adamsls/Analog-to-Digital-Converter/ADC.jpg

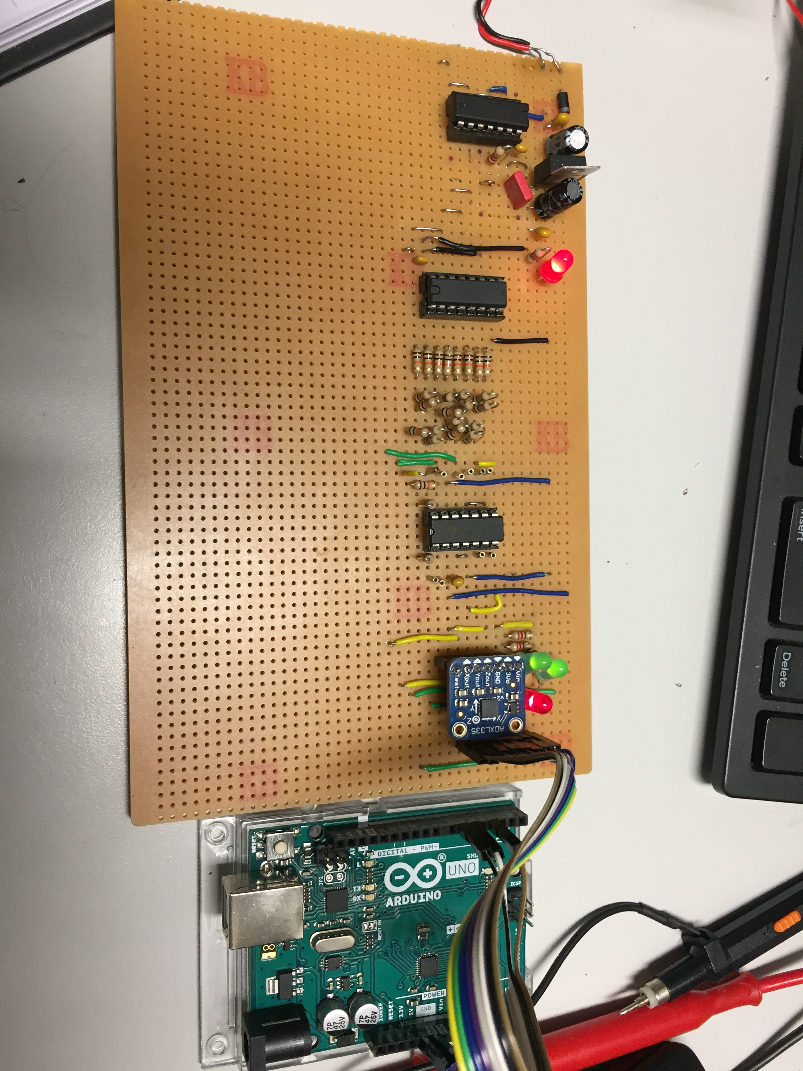
ADC.jpg
