adamsls/Analog-to-Digital-Converter/ADC Project Report.pdf

# FLASHE PROJECT 2019

# Successive Approximation ADC

## LINDA ADAMS

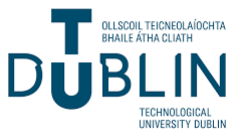
[picture p2: figure]

DEPARTMENT OF ELECTRONIC ENGINEERING TECHNOLOGICAL UNIVERSITY DUBLIN TALLAGHT CAMPUS
JUNE 2019

## Table of Contents

## Introduction

The project outlined in this report involves the construction of a Successive Approximation Analogue to Digital Converter. The circuit takesin an analogue voltage value from an on-board accelerometer and outputs a digital PWM signal, via an embedded Arduino board. Thisreport will describe the functions of the different sections of the converter, the process of building each section and its implementation, and details of how the circuit how tested. Finally, there will be a discussion of the project and what was learned.

## Acknowledgements

With thanks to Fergal Brennan and Martin Fogarty.

## Project planning

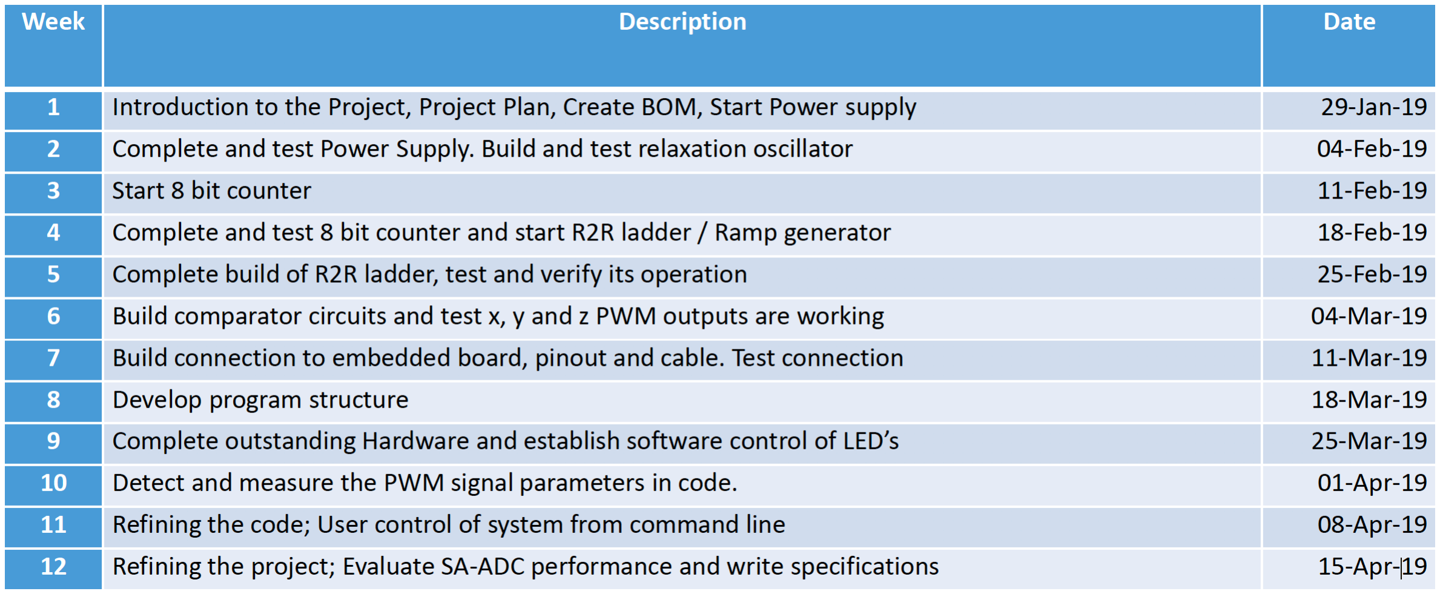
[picture p3: figure]

## Overview of the Circuits

Voltage Regulator

The first section of the ADC consists of a voltage regulator circuit. A voltage regulator is necessary as it important to have a steady, regular power supply to power the rest of the board. This may not be possible from a bench PSU as they may be prone to excessive AC ripple. AC Ripple is the slight variation in a DC signal caused by inadequate conversion of the AC source voltage to DC [1]

The primary component in this section is an LM7805CT, a linear voltage regulator with fixed voltage output of 5V [2]. The LM7805CT is particularly efficient for this purpose as it can dissipate a lot of heat [3]. The regulator functions by essentially comparing the output voltage to a reference voltage and adjusting based on error until the required output voltage is met [4].

Decoupling capacitors are used to filter the input signal from the PSU to the regulator, and are also used on the IC’s output to filter and smooth the output signal. In the context of the full circuit, AC Ripple may potentially become a problem, as it may interfere with the very small reference voltage values output by the ramp generator and the values output by the accelerometer. Therefore it is important to filter the signals in order to reduce AC Ripple as much as possible.

A load resistor is connected to the output of the LM7805CT as is an LED, for testing purposes. A rectifier diode is placed on the IC input, to further reduce AC Ripple.

Relaxation Oscillator

The next section of the ADC consists of a relaxation oscillator. The function of this relaxation oscillator is to act as a clock. The frequency of this clock will determine the eventual Pulse Width Modulation frequency of the output of the comparator..

The primary component at this stage is an LM74AC, a Hex Inverter with Schmitt Trigger Input. The LM74AC chip contains six inverter gates with Schmitt Trigger inputs [5], two of which are used in this circuit.

The first gate functions essentially as a comparator, comparing the input to the gate with negative and positive threshold voltages. According to the datasheet, the negative threshold for a 5V input is 1V, and the positive 3.55V. A capacitor is placed on the inverting input of the gate, and it is the rate of discharge/discharge of this oscillator that determines the frequency of the output of the oscillator. When the gate is powered, there will be 5V on its output which will then be fed back to the inverting input, causing the capacitor to begin charging. When the capacitor reaches 3.55V, it will then be greater than the positive threshold voltage, and so the output will switch to 0V. At that point the capacitor will begin discharging. When it discharges to the point where it is less than the negative threshold voltage, then the output will switch to 5V. In this way, a 5V square wave is generated. Schmitt Trigger inputs implement hysteresis in the form of the thresholded range of voltages described above (1V – 3.55V). This is used in order to avoid rapid fluctuations between 0V and 5V.

Counter

In this stage of the ADC, a counter is used to create an 8-bit count from 0 to 255, which will be used to generate a ramp output from the next stage of the circuit. The main component in this section is an SN74HC590, an 8-bit digital counter. The clock input to this binary counter comes from the relaxation oscillator built in the previous section. The output of the oscillator was found to be 188.7kHZ, and so this will be twice the frequency of the Least Significant Bit (LSB) of the counter output. If we count the LSB as the “1st” bit and the MSB as the “8th”, then the nth bit will be have a frequency that is 2" divisions of the LSB frequency, i.e.:

ntℎ bit frequency = 188,700 2"
According to the SN74HC590 datasheet [6], the IC contains both a counter and a storage register, with a separate clock input for each of these. The counter clock is positive-edge triggered, meaning that when the oscillator transitions from low to high, the counter will increment. The clock may be reset through the !CCLR clock clear pin, or enabled through the !CCKEN clock enable pin. An RCO (Ripple Carry Output) pin may be used if multiple counters were to be chained together.

Ramp Generator

The next section of the circuit consisted of an R2R Resistor Ladder. An R2R Ladder is essentially a series of voltage dividers that output a ramp voltage. This ramp voltage will function as a reference voltage to which the eventual output of the accelerometer will be compared.

The input to the R2R ladder is the 8-bit output of the counter. This consists of 8 separate square wave signals, each half the frequency of the next. Given that these are binary signals, the R2R ladder can be thought of as functioning as a local digital-to-analogue converter [7], within the global analogue-to-digital circuit.

Each bit contributes a proportional amount of voltage to the total summed voltage at the output of the R2R ladder, resulting in a 5V sawtooth wave.

Comparator

At the nextstage of the circuit, an ADXL335 3-axis accelerometer will be added to the board. The accelerometer will output voltage values relative to its rate of acceleration in the x-, y-, and z-axes. These voltage values will be compared to the ramp output of the R2R ladder, using an LM339 chip, which contains four comparators [8]. For each axis signal comparison, a Pulse Width Modulated square wave will be output, whose duty cycle ratio corresponds to the acceleration in that axis.

In this way, the analogue voltage output of the accelerometer is converted to digital values that may be interpreted by an Embedded System.

Embedded Interface

At this stage of the circuit, pin headers are soldered to the board so that an ADXL335 3-axis accelerometer and an Arduino Uno SMD may be added. The accelerometer outputs analogue voltage values relative to its rate of acceleration in the x-, y-, and z-axes. The values are then routed to the comparator, which compares them to the analogue reference ramp voltage and outputs three digital Pulse-Width Modulated signals. The PWM signals can be interpreted as the positions of the accelerometer in the X, Y, and Z planes, or as g-force values between -3g and 3g. The values are routed to the Arduino. A programme is embedded onto the Arduino which can interpret the incoming PWM signals and display these in the serial monitor.

Coding

There are three values from the accelerometer that will need to be read and interpreted by the embedded Arduino programme. Therefore, there are three main functions within the code, each containing a switch statement for the individual axis readings. For example, when the ‘x’ key is pressed by the user, the variable pwm_x_measurement is set to ‘THI’, and a boolean flag named ok_to_measure_pwmx is asserted. This allows the function to measure the x-axis value from the accelerometer, MeasurePWMX, to be called, with pwm_x_measurement, set to ‘THI’, as an initial argument. The first case of the switch statement is implemented, which contains a call to the inbuilt Arduino function pulseIn() [9]. PulseIn() reads the PWM input from the given pin and returns its HIGH duration in microseconds, which is assigned to pwm_x_thi. The switch breaks and the flag, still asserted, is rechecked. MeasurePWMX is again called, and the next case of the switch statement implemented, with pwm_x_measurement set to ‘TLO’, and the LOW duration of the PWM signal is returned. In the next case, the low and high values are summed to give the period of the PWM signal. In the next case, the function CalculateVin is called, which divides the HIGH duration by the clock period. This gives the number of steps that the ramp has incremented while the comparator output is high. Multiplying this value by resolution of the ramp 6

788
9: ;, gives the voltage value coming from the accelerometer. This value is them

displayed on the serial monitor, as is the HIGH duration, LOW duration and the total PWM period.

Functions to calibrate the board and to convert voltage values to G forces, using points taken during calibration and determining the line equation for each axis, are added.

## Implementation of the Circuits

Voltage Regulator

In this section of the circuit, a DC voltage is taken from a bench PSU (or battery). A ground rail is also established at this point. The input voltage is sent through first through a rectification diode, in order to alleviate AC Ripple. It is further smoothed using an input filter consisting of decoupling capacitors and finally routed through the input pin of the LM7805CT voltage regulator. According to the datasheet for the LM7805CT, the dropout voltage is 2.0V. This means that for an output of 5V, we can calculate the expected minimum required voltage from the PSU as:

V=>? + VAB=C=>? = VDE(GDE)

∴ 5V + 2V = 7V

According to the datasheet, the maximum input voltage should be 35V. A voltage of 12V is used, giving ample headroom on either side. The datasheet states that the output voltage tolerance is +/- 4%, and therefore we can calculate the expected output voltage range as:

V=>?(BKELM) = 5V ± 4%

∴ V=>?(BKELM) = 5V ± 0.2V

∴ 4.8V ≤ V=>? ≥ 5.2V

The resulting 5V (+/- 4%) is routed through an output filter for smoothing and then sent through a diode and load resistor.

It is important to ensure that there are no short circuits in this section, as this may cause the LM7805CT to overheat due to too much current flowing through it. If the regulator overheats and enters thermal shutdown, its output voltage may drop below the required value [3].

Relaxation Oscillator

In this second stage of the circuit, the voltage regulator output is routed to the input of a relaxation oscillator, built from an LM74AC IC described above. The output of this oscillator is a square wave, which has been generated via one of the inverter gates of the IC. A second inverter gate functions as a clock buffer to smooth the square wave and reduce noise.

The expected frequency output of the oscillator is a function of the time constant of the circuit and the various input and threshold voltage values [10]. Therefore, when calculating this value, the RC constant must first be determined. The resistance and capacitance of R and C were measured:

RUVWXYZV[ = 214.8Ω

CUVWXYZV[ = 21.218nF

∴ RCUVWXYZV[ = 214.8 × (21.819 × 10ab)

∴ RCUVWXYZV[ = 4.6867 × 10ad

This may be compared to the labelled values of the components in order to illustrate the range of tolerance in component labelling:

ReWfVeeV[ = 220Ω

CeWfVeeV[ = 22nF

∴ RCVghVijV[ = 220 × (22 × 10ab)

∴ RCVghVijV[ = 4.84 × 10ad

The deviation between the expected and the measured may then be calculated as a percentage:

Percentage error = |RCUVWXYZV[ − RCVghVijV[|
RCVghVijV[

×

100
1

= 1.522 × 10aq
4.84 × 10aq ×

100
1

= 3.17%

The overall output square wave frequency is determined by the following calculation:

f = | 1
RC ln 6
| Vuu − V?a Vuu − V?v
×

V?v
V?a

;

RC was determined above to be 4.84 × 10ad and VCC determined to be 5.06V (see Testing and Results – Voltage Regulator). However, the VT- and VT+ values were not so easily determined as they were found to be values within a given tolerance range, according to the datasheet. Therefore, the potential output frequency had to be calculated within that range, with RC and Vcc as constants, and VT- and VT+ as variables. The calculated values are listed below (the excel table for these values may be found in the appendix):

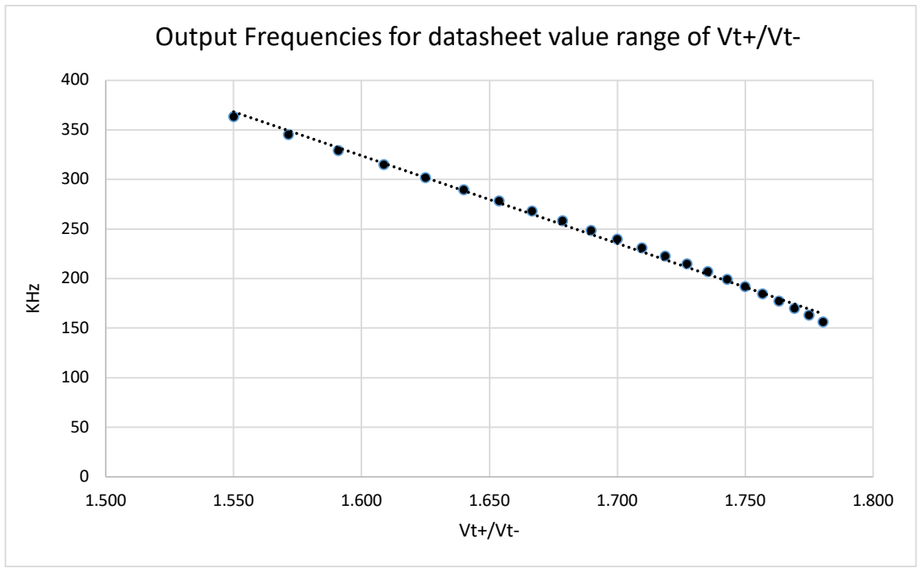
[picture p4: figure]
KHz

Counter

At this stage of the circuit, the output of the relaxation oscillator is routed to the clock input pins (CCLK/Counter and RCLK/Registry) of the SN74HC590. The active low CCLR/Counter Clear pin is routed to the 5V line in order to prevent the counter being cleared to 0, and the

Output Frequencies for datasheet value range of Vt+/Vt-active low OE/Output Enable and CCKEN/Count Enable pins are routed to ground to ensure that the count will continue.

The SN74HC590 will output, from 8 separate pins, parallel binary values that will constitute an 8-bit count from 0 to 255:

Decimal | Bit 7 (MSB) | Bit 6 | Bit 5 | Bit 4 | Bit 3 | Bit 2 | Bit 1 | Bit 0 (LSB)
0 | 0 | 0 | 0 | 0 | 0 | 0 | 0 | 0
1 | 0 | 0 | 0 | 0 | 0 | 0 | 0 | 1

254 | 1 | 1 | 1 | 1 | 1 | 1 | 1 | 0
255 | 1 | 1 | 1 | 1 | 1 | 1 | 1 | 1

Table 1: 2^8 binary output values

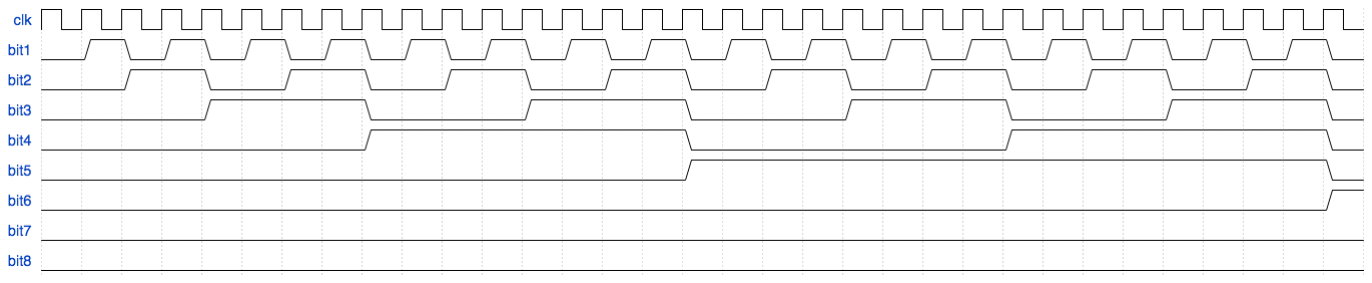
[picture p5: figure]

Figure 1: Section of 8-bit counter timing diagram
Each of these binary outputs will constitute an on/off voltage of 0V and 5V which will be fed into an R2R resistor ladder in the next stage of the circuit. The resistor ladder will take this square wave input and convert it into a ramp voltage.

Ramp Generator

Each square wave signal from the counter, detailed in the previous section, is routed separately to the R2R ladder. The ladder is set up in such a way that each individual square wave meets a different level of impedance, which is inversely proportional to the associated bit’s significance in the overall 8-bit byte [11]. For example, the Most Significant Bit meets the minimum level of resistance and the Least Significant Bit meets the maximum level. This means that each bit allows for a voltage output proportional to its significance, i.e. MSB allows for the maximum voltage, LSB allows for the minimum.

This proportional voltage output is achieved through the ladder sequence of voltage dividers, with values of 2R for R1 and 2R (through Thevenin equivalence [12]) for R2. Each bit is connected to a voltage divider and must travel through its connected voltage divider, plus all subsequent voltage dividers. Hence, each bit voltage is successively divided, relative to its significance. For example, the LSB must travel through eight voltage dividers, which reduces its voltage by 2w. The MSB must only travel through one voltage divider, reducing its voltage by 2x. If we count the LSB as the “8th” bit and the MSB as the “1st”, then the nth bit will contribute voltage according to the following equation:

ntℎ bit voltage output = V|" 2"

Bit number | Expected voltage output (when high)
1 (MSB) | }.~d7 9 = 2.53V
2 | }.~d7 9Ä = 1.265V
3 | }.~d7 9Å = 0.633V
4 | }.~d7 9Ç = 0.316V
5 | }.~d7 9É = 0.158V
6 | }.~d7 9Ñ = 0.079V
7 | }.~d7 9Ö = 0.040V
8 (LSB) | }.~d7 9: = 0.020V
Total (max - 255) | 5.04V

Table 2: Calculated voltage output values for individual bits

The resulting voltages are summed, with the maximum value of the sum being the initial square wave peak voltage of 5V. As the binary counter increments, the summing voltages increase proportionally to the bits, resulting in a ramp voltage. Given that the minimum contribution to the ramp is the input voltage having travelled through eight successive voltage dividers, the resolution of the ramp is:

Resolution = V|"
2w
Resolution = 5.06V
256

Resolution = 19.77mV

The resolution of the ramp is extremely important, as this will be the minimum voltage that can be compared with the output of the accelerometer.

The construction of the circuit involved placing the resistors according to the network structure. The R resistor value in this case was 5kW. Two 10kW resistors were used for the R value instead of a single 5kW resistor, as this increases tolerance from ± 5% for a single resistor to ± 2.5%.

Comparator

At this point, the ramp voltage is routed to three inverting inputs of the inverting LM339 comparator. When the ADXL335 3-axis accelerometer is added to the board, then its 3-axis outputs will be routed to the non-inverting inputs of the LM339. However, during the implementation phase of this circuit, test voltages are taken from the bench PSU, in order that the functioning of the comparator may be easily tested using known values.

The comparator functions by comparing two input signals and outputting a binary “high” signal when the non-inverting input is greater than the inverting input. When the reverse is true, a binary “low” value is output. As the accelerometer voltage will be compared to a sawtooth wave, the output will be constantly low if the accelerometer output is low, constantly high if the accelerometer output is high, and a 50% duty cycle square wave if the accelerometer output is at its mid-point. Given a constant DC test voltage input from the PSU during testing, the output will be high for all points where the test voltage is higher than the ramp voltage, as seen below (adapted from [13]):

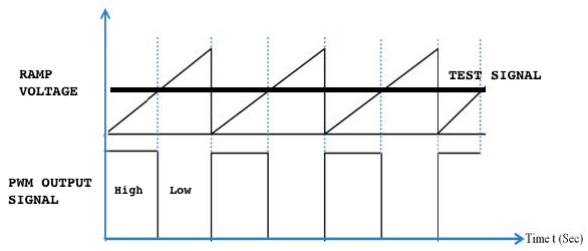
[picture p6: figure]

Figure 2: PWM Output from Comparator

One of the issues involved with Pulse Width Modulated signals is that of “cross-over”. This refers to the problem of measuring the maximum and minimum values of a PWM signal. If the test signal is at a maximum or minimum, then it will be fully higher or fully lower than the reference signal. If this occurs then there will be no differentiation between high and low in the output, and the output will cease to have a frequency component. This means that it will become a DC signal with a constant voltage of max or 0. Therefore it is important to find the minimum and maximum voltages at which a frequency exists. These will determine the specifications within which the device may operate.

The system transfer function must be determined at this point, in order to be able to understand exactly how the PWM output of the comparator relates to the actual voltages produced by the accelerometer. The values that will determine this transfer function are the ramp voltage (F_RAMP), frequency of the oscillator (F_CLK) and the supply voltage (VCC). Some of these values were measured/calculated at various other points:

Fuàâ = 188.7kHz

VCC = 5.06V

The frequency of the square wave ramp may be calculated by dividing the clock frequency by the number of steps in the ramp, as each step in the square wave occurs at the pulsing of the clock:

FBKGC = 188.7kHz
2w
FBKGC = 737.1Hz

The period of the ramp (and thus the period of the PWM output) is the reciprocal of the frequency:

TBKGC = 1 737.1Hz

TBKGC = 1.36ms

The resolution of the ramp has previously been calculated as 19.77mV. In order to calculate the duration that the PWM will be high or low given a test input signal, the number of steps required by the ramp to reach that test value must be calculate:

NUM_STEPS = V?Mî? Resolution

As we cannot have a non-integer amount of steps, this number must be rounded, which introduces a rounding error. The rounding error may be found by subtracting the calculated value (step voltage * step number) from the actual test value.

The time taken for the ramp to reach the test voltage is equal to the ramp step time (clock period) multiplied by the amount of steps required. This time value represents the duration that the output PWM signal will be high:

TïDLï = Tuàâ × NUM_STEPS

The duration that the PWM signal will be low may be found by subtracting T_HIGH from the overall period of the ramp, T_RAMP:

Tà=ñ = TBKGC − TïDLï

Therefore, if T_CLK for this circuit is 5.3µs, and the resolution is 19.77mV, then the high PWM value for any test input may be found using:

TïDLï = V?Mî? ×

Tuàâ
Resolution
TïDLï = V?Mî? × (2.68 × 10aó)

Embedded Interface

During the implementation of the embedded interface stage, some rerouting was required. At this point, the 5V signal from the voltage regulator was no longer required to pull up the outputs of the comparator, as 5V would now be taken from the Arduino. This required the removal of the link between the comparator output signals and the voltage regulator 5V line, since there would be no common reference if two different 5V supplies were used. Additionally, a link needed to be made to the 5V Vcc input from the Arduino.

Two pin headers were required in order to allow for both a 3-axis accelerometer, the ADXL335, and an Arduino Uno SMD to be connected.

According to the datasheet for the ADXL335 [14], the device operates by measuring the differential capacitance between a fixed plate and a plate attached to a mass, which moves when the device is moved. This differential represents the acceleration within a given axis, which may also be converted to a g-force value. The ADXL335 contains an on-board regulator, which allows it to operate within a 3.3V range while taking in a 5V input [15]. It outputs ratiometric/proportional values, meaning that the range of output voltages is scaled along with the possible range of g-force values available.

On the circuit, the X, Y and Z acceleration outputs were routed from the pin header to which the ADXL335 will be connected to the test voltage inputs of the comparator.

## Bill of Materials

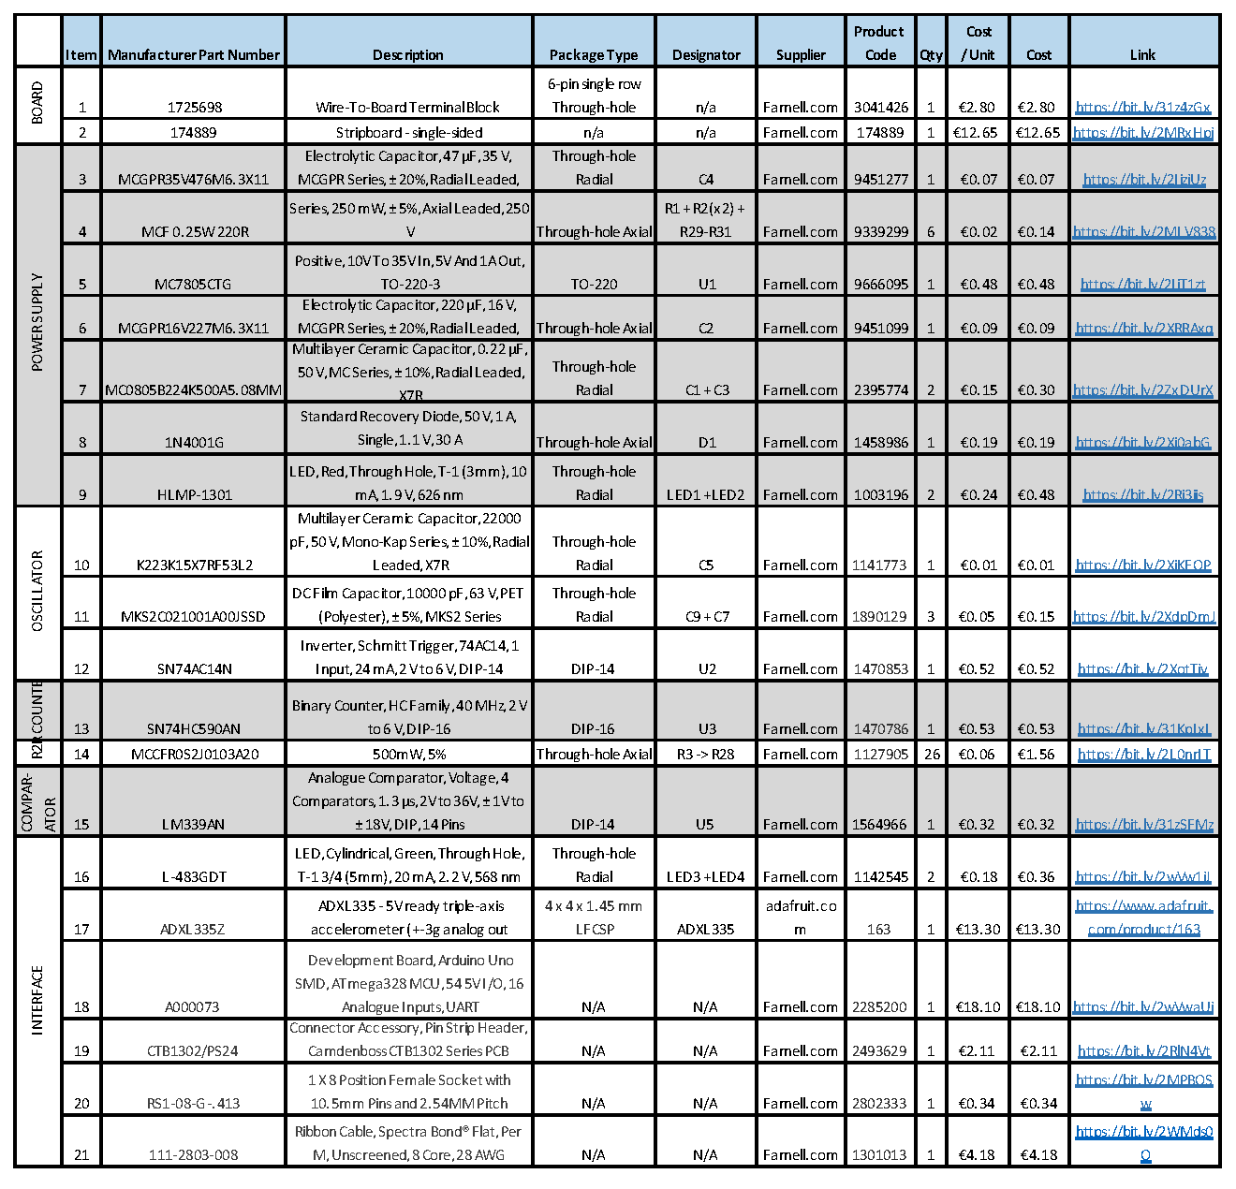
[picture p7: figure]

## Errors

Some errors occurred at various stages during the implementation of the circuit. These were dealt with as follows:

Voltage Regulator

During the voltage regulator stage, the terminal block component was found to have been soldered incorrectly to the board, as it had been positioned backwards. The component was removed using solder removal braid and a new component sourced and resoldered.

Relaxation Oscillator

Initial tests of the relaxation oscillator showed that it was not outputting at the expected frequency. After inspection of the board, it was found that some cuts in the board had not been made properly, and some unintentional connections in the tracks remained. After recutting the appropriate sections, the oscillator began clocking at the expected frequency.

R2R Ladder

It was initially found that the ramp voltage from the R2R was not incrementing smoothly, but rather was jagged and uneven. On inspection of the board, it was found that a track cut had not been made. The appearance of the ramp improved significantly one the cut was made.

Embedded Interface

On testing the PWM output of the comparator, it was found that a signal was not being obtained for the Z-axis of the accelerometer. After inspecting the circuit visually, a burned section of the board was found between the PWM_Y output of the 5V line, through the pull-up resistor. This was subsequently rerouted, but the problem persisted. Continuity measurements were then taken, and it was found that the connection between the Y-axis output of the accelerometer header and the comparator input was broken. This also was then rerouted, but again the problem persisted. Resistance values were then taken using the multimeter, and a short to ground at the U-output of the comparator was discovered. A visual inspection of the board revealed an accidental connection to the ground line through excess solder on a joint. The joint was de-soldered and cleaned up, and this appeared to solve the problem.

Coding

An issue was found with the PulseIn() function of the embedded code. On occasion, the function returned erroneously low values for the HIGH PWM duration, in the area of 10 – 20 µs. On inspection of the PWM signal using the oscilloscope, it was discovered that there were slight glitches in the X and Z signals, where the value went from HIGH to LOW to HIGH again, or vice versa, over the course of approximately 20µs. According to the Arduino documentation for PulseIn(), the function waits for the pin value to change and then begins timing. It then waits for the value to change again and stops timing [9]. Therefore it is likely that the function was reading the PWM glitches as valid signals. Since the function waits for the value to change, it was decided that a debounce-type solution may be effective, and an if-statement included in the ReadPulse() function that implemented a new call to PulseIn() if the initial value was less than 20µs. This appeared to solve the problem.

## Testing and Results

Voltage Regulator

Given that the main function of the voltage regulator is to output a specified voltage, the first test performed was on the output voltage of this section of the circuit. As calculated above (see Implementation – Voltage Regulator), the expected output was between 4.8V and 5.2V. The output voltage, when tested, was found to be 5.06V, within the expected margin of error. AC Ripple was also measured at this stage and found to be approx. 50mV. The minimum input voltage was calculated above to be approx. 7V. When measured, this value was found to be 7.23V, which was reasonably close to the expected value. The current from the bench PSU was also measured, and found to be 17.9mA

Minimum | Typical | Maximum
7V | 12V | 35V

Table 3: Input Voltage Values

Value | Description | Expected | Measured
Vin Min | Minimum input voltage | 7V | 7.23V
VDD | Output voltage | 4.8V -> 5.2V | 5.06V
PIN | Input current | ---------- | 17.9mA
VAC RIPPLE | AC Ripple on input voltage | ---------- | 50mV

Table 4: Test Results for Voltage Regulator

Relaxation Oscillator

Values related to the input and output of the oscillator were tested at this stage, in order to ensure that this section of the circuit was functioning correctly. The estimated value for the output frequency was 159.35kHZ ≤ f ≥ 365.23kHz (see Implementation – Relaxation Oscillator). When measured on the oscilloscope, the output period was found to be 5.3 μs, which meant that the frequency was 188.7kHz, which is within the expected range. The ratio of positive to negative pulse width was measured, with the positive width found to be 2.9 μs and the negative 2.4 μs. Ideally, these would have the same value, but the unequal ratio was not found to be overly problematic. The rise time and fall time were also measured, and found to be 30ns and 20ns, respectively.

As before, the voltage and current into the circuit and the AC ripple were measured to see if they had changed given the expansion of the circuit. They were found not to have deviated significantly.

Value | Expected | Measured
Circuit voltage | 12V | 12.8V
Circuit current | ----- | 29mA
Positive pulse width | ----- | 2.9µs
Negative pulse width | ----- | 2.4µs
Output frequency | 159 -> 365 kHz | 188.7kHz
Output Period | 1/159k -> 1/365k seconds | 5.3µs
Rise time | ---- | 30ns
Fall time | ---- | 20ns

Table 5: Test Results for relaxation oscillator

Counter

Testing at this stage of the circuit involved determining the output frequencies of each of the 8 output pins of the counter and comparing these frequencies to expected values.

Frequencies were calculated using the equation:

ntℎ bit frequency = 188,700 2"

Output | Calculated Frequency (Hz) | Measured Frequency (Hz) | Difference (Hz) | Difference (%)
Bit 1 (O/p A0) | 188,700 / 2 = 94,350 | 95,700 | + 1350 | 1.4
Bit 2 (O/p A1) | 188,700 / 4 = 47,175 | 47,000 | -175 | 0.3
Bit 3 (O/p A2) | 188,700 / 8 = 23,587 | 23,900 | +313 | 1.3
Bit 4 (O/p A3) | 188,700 / 16 = 11,794 | 11,900 | +196 | 0.9
Bit 5 (O/p A4) | 188,700 / 32 = 5,897 | 5,980 | +83 | 1.4
Bit 6 (O/p A5) | 188,700 / 64 = 2,984 | 3,000 | +16 | 0.5
Bit 7 (O/p A6) | 188,700 / 128 = 1,474 | 1,490 | +16 | 1.1
Bit 8 (O/p A7) | 188,700 / 256 = 737 | 747 | +10 | 1.3

Table 6: Test Results for 8-bit Counter

AC Noise was again measured at this point and found to be approx. 25mV, and power consumption was calculated from the input voltage and current and found to be 0.36 Watts.

Ramp Generator

The ramp generator was tested by measuring the resistance values throughout and across the circuit and comparing them to expected calculated values. If the resistance values were found to be correct, then it is assumed that the voltage values contributing to the ramp will be correct.

Test Point 1 | Calculated Value | Measured Value | Difference (%)
GND to A0 | 20kW | 19.68kW | 1.61
GND to A1 | 25kW | 24.50kW | 2.02
GND to A2 | 30kW | 29.42kW | 1.95
GND to A3 | 35kW | 34.28kW | 2.08
GND to A4 | 40kW | 39.20kW | 2.02
GND to A5 | 45kW | 44.10kW | 2.02
GND to A6 | 50kW | 49.01kW | 1.99
GND to A7 | 55kW | 53.98kW | 1.87

Table 7: Measured and calculated resistances across R2R ladder

Test Point 2 | Calculated Value | Measured Value | Difference (%)
A0 to A1 | 25kW | 24.49kW | 2.06
A1 to A2 | 25kW | 24.42kW | 2.34
A2 to A3 | 25kW | 24.41kW | 2.38

A3 to A4 | 25kW | 24.41kW | 2.38
A4 to A5 | 25kW | 24.43kW | 2.31
A5 to A6 | 25kW | 24.42kW | 2.23
A6 to A7 | 25kW | 24.50kW | 2.02
A7 to A0 | 55kW | 53.80kW | 2.21

Table 8: Measured and calculated resistances within R2R ladder

In addition, the output ramp voltage was checked on the oscilloscope to ensure that it was outputting the correct shape and magnitude sawtooth wave. As seen below, the output voltage was found to be a 5V sawtooth wave as expected, and the step size was found to be approximately 20mV:

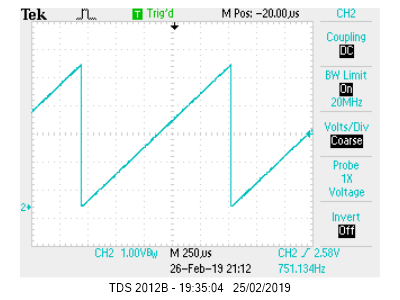
[picture p8: figure]

Figure 3: Ramp output of R2R ladder

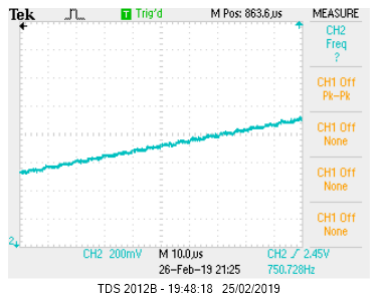
[picture p9: figure]

Figure 4: Individual step size in ramp output

AC Noise was again measured at this point and found to have increased significantly from 25mV to approx. 60mV with the addition of the R2R ladder to the circuit.

Comparator

Testing for the comparator involved using the oscilloscope to find the minimum test input voltage value for which the output PWM signal had both a high and low portion. Beyond this point, the PWM will be a DC signal with only a continuous low value, which is of no use. The maximum voltage value was also measured. The useful range of voltages was thus calculated.

In addition, the frequency, period, and voltage of the PWM signal was measured and compared to calculated values, and a range of high/low PWM durations were measured for the test input.

Finally, the power consumption of the circuit at this point was found to be 0.41W, an increase on the previous value of 0.36W

Value | Expected | Measured
| | X | Y | Z
Vsig_min | ------- | 9mV | 9mV | 8mV
Vsig_max | ------- | 5.062V | 5.06V | 5.1V
Vsig_range | ------- | 5.053V | 5.051V | 5.092V
VPWM | 5.06V | 5.12V | 5.12V | 5.12V
F_PWM | 737.1Hz | 752.7Hz | 751.8Hz | 746Hz
T_PWM | 1.36ms | 1.33ms | 1.33ms | 1.34ms

Table 9: Measured and calculated values for comparator

Vsig | X | Y | Z
| Pos PWM | Neg PWM | Period | Pos PWM | Neg PWM | Period | Pos PWM | Neg PWM | Period
1V | 263.9µs | 1.065ms | 1.33ms | 270µs | 1.06ms | 1.33ms | 269.1µs | 1.071ms | 1.34ms
2V | 523.2µs | 806.1µs | 1.33ms | 521.9µs | 808.1µs | 1.33ms | 527.8µs | 812.2µs | 1.34ms
3V | 807.9µs | 520.8µs | 1.33ms | 810µs | 520µs | 1.33ms | 814.6µs | 525.4µs | 1.34ms
4V | 1.053ms | 276µs | 1.33ms | 1.072ms | 258µs | 1.33ms | 1.063ms | 276µs | 1.34ms

Table 10: Measured PWM values

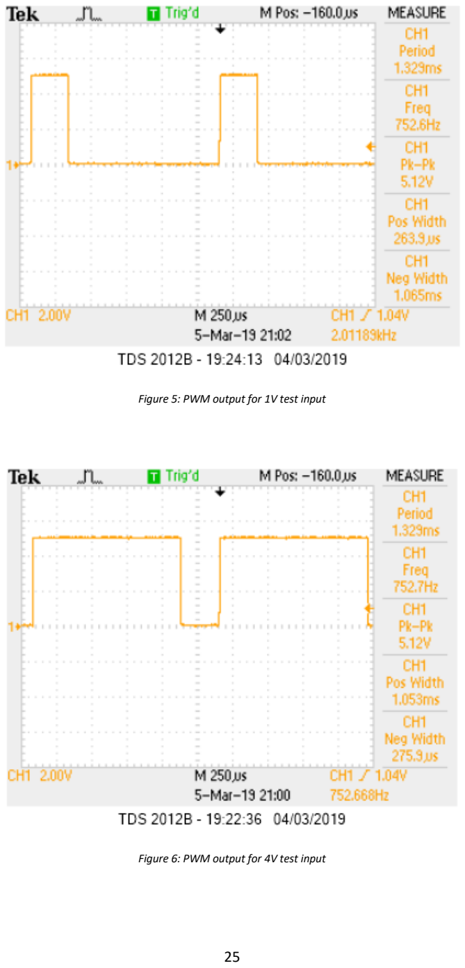
[picture p10: page 28]

Figure 5: PWM output for 1V test input

Figure 6: PWM output for 4V test input

Embedded Interface

Testing of the embedded interface involved taking many of the same measurements as in the previous stage. The difference in this case however, was that the test voltages were routed from the bench PSU through the accelerometer header pins, in order to ensure that the wiring and rerouting necessary for this stage had been correctly completed. Only the varying voltages for the X-axis were tested in this case.

Value | Expected | Measured
| | X | Y | Z
Vsig_min | ------- | 10mV | 9.5mV | 9.7mV
Vsig_max | ------- | 5.15V | 5.12V | 5.2V
Vsig_range | ------- | 5.14V | 5.025V | 5.103V
VPWM | 5.06V | 5.18V | 5.2V | 5.17V
F_PWM | 737.1Hz | 746Hz | 742Hz | 752Hz
T_PWM | 1.36ms | 1.34ms | 1.35ms | 1.33ms

Table 11: Measured and calculated values for comparator

Vsig | Pos PWM | Neg PWM | Period
1V | 273.5µs | 1.067ms | 1.34ms
2V | 516.4µs | 823.6µs | 1.34ms
3V | 821µs | 519µs | 1.34ms
4V | 1.1ms | 24µs | 1.34ms

Table 12: Measured PWM values

Power consumption was again measured at this stage, and found to be 0.372W, a slight increase on the previous measurement. AC Noise was measured, and found to be approx. 65mV, also a slight increase on the previous measurement.

Coding

Testing this code for the project involved ensuring that the values output to the serial monitor corresponded with values that would be reasonably expected for particular movements of the board. For example, lying the board flat should result in values of 1g in the z-axis as a result of acceleration due to gravity (g), and values of 0g in both other axes.

In addition, the voltages values displayed on the serial monitor were compared with voltages measured at the accelerometer by the multimeter.

Position | G-force | VSERIAL | VMEASURED | Difference (%)
0o x-axis | -1g | 1.88V | 1.74V | 7.7
90o x-axis | 0g | 1.56V | 1.63V | 4.3
180o x-axis | 1g | 1.32V | 1.4V | 5.9
270o x-axis | 0g | 1.54V | 1.61V | 4.4

Table 13: X-axis Voltage values from serial monitor and multimeter

Position | G-force | VSERIAL | VMEASURED | Difference (%)
0o y-axis | -1g | 1.86V | 1.94V | 4.2
90o y-axis | 0g | 1.72V | 1.84V | 6.7
180o y-axis | 1g | 1.25V | 1.29V | 3.1
270o y-axis | 0g | 1.68V | 1.61V | 4.2

Table 14: Y-axis Voltage values from serial monitor and multimeter

Position | G-force | VSERIAL | VMEASURED | Difference (%)
0o z-axis | -1g | 1.36V | 1.41V | 3.6
90o z-axis | 0g | 1.7V | 1.84V | 7.9
180o z-axis | 1g | 1.96V | 2.02V | 3
270o z-axis | 0g | 1.68V | 1.72V | 2.3

Table 15: Z-axis Voltage values from serial monitor and multimeter

From this analysis, it was determined that the maximum voltage values, and thus maximum g-force values due to gravity occurred at 180⁰

, and the minimum occurred at 0⁰ . Thus the g-force relative to position could be thought of as an inverted cosine wave.

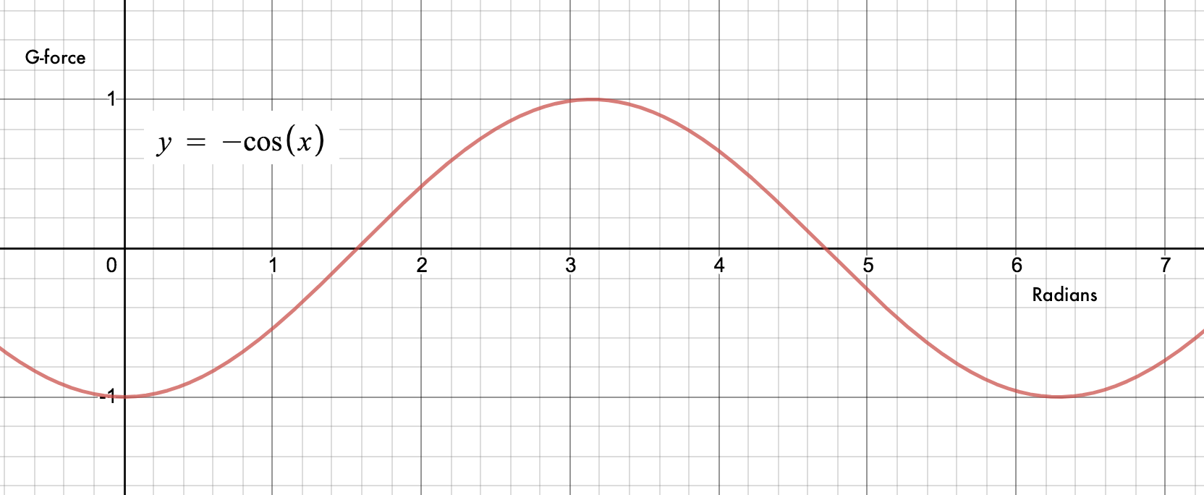
[picture p11: figure]

Figure 7: G-force as a cosine function of position in degrees

The period of the wave could be calculated by taking the range of voltage values between the max and min (half-wave period) and multiplying by two. Taking 2p divided by this period would give the coefficient on x for the cosine wave equation:

g force = −1 cos ù 2π
2(VUWg − Vü†° )

x£

g force = −1 cos § π VUWg − Vü†°
x•

This equation was implemented in the embedded code in a function convert_to_g(), using the external Arduino library math.h.

## References

[1] “What is Ripple? - Sunpower UK.” [Online]. Available: https://www.sunpower-uk.com/glossary/what-is-ripple/. [Accessed: 09-Jun-2019].
[2] Fairchild, “3-Terminal 1 A Positive Voltage Regulator,” LM78XX / LM78XXA datasheet, 2014.
[3] “Linear Voltage Regulators (LM7805) | AO #17 - YouTube.” [Online]. Available:
https://www.youtube.com/watch?v=OAoEWaGtQjs. [Accessed: 08-Jun-2019].
[4] “All About 7805 IC | Voltage Regulator.” [Online]. Available:
https://electronicsforu.com/resources/learn-electronics/7805-ic-voltage-regulator. [Accessed: 09-Jun-2019].
[5] Fairchild, “Hex Inverter with Schmitt Trigger Input,” 74AC14 / 74ACT14 datasheet, 2011.
[6] “SN54HC590A, SN74HC590A 8 BIT BINARY COUNTERS WITH 3 STATE OUTPUT REGISTERS,” SN54HC590A, SN74HC590A datasheet, 2003.
[7] P. Horowitz and W. Hill, The art of electronics. Cambridge University Press, 2015.
[8] “LM139, LM239, LM339 Low-power quad voltage comparators,” LM139, LM239, LM339 datasheet, 2011.
[9] “Arduino Reference.” [Online]. Available: https://www.arduino.cc/reference/en/language/functions/advanced-io/pulsein/. [Accessed: 16-Jun-2019].
[10] “How to Design Schmitt Trigger Oscillators.” [Online]. Available: https://www.allaboutcircuits.com/technical-articles/how-to-design-schmitt-trigger-oscillators/. [Accessed: 09-Jun-2019].
[11] “DAC Methods R2R Ladder - YouTube.” [Online]. Available: https://www.youtube.com/watch?v=bXUfDLF4MVc. [Accessed: 13-Jun-2019].
[12] “The Operation and Characteristics of Voltage-Mode R-2R DACs.” [Online]. Available: https://www.allaboutcircuits.com/technical-articles/voltage-mode-r2r-dacs-operation-and-characteristics/. [Accessed: 14-Jun-2019].
[13] Z. Nouman, B. Klima, and J. Knobloch, “Generating PWM Signals With Variable Duty From 0% to 100% Based FPGA SPARTAN3AN,” Elektrorevue, vol. 4, no. 4, pp. 75–79, 2013.
[14] “ADXL335 (Rev. B),” ADXL335 datasheet, 2010.
[15] “ADXL335 - 5V ready triple-axis accelerometer (+-3g analog out) ID: 163: Adafruit Industries, Unique &amp; fun DIY electronics and kits.” [Online]. Available: https://www.adafruit.com/product/163. [Accessed: 15-Jun-2019].

## Appendix

Calculations for Relaxation Oscillator frequency

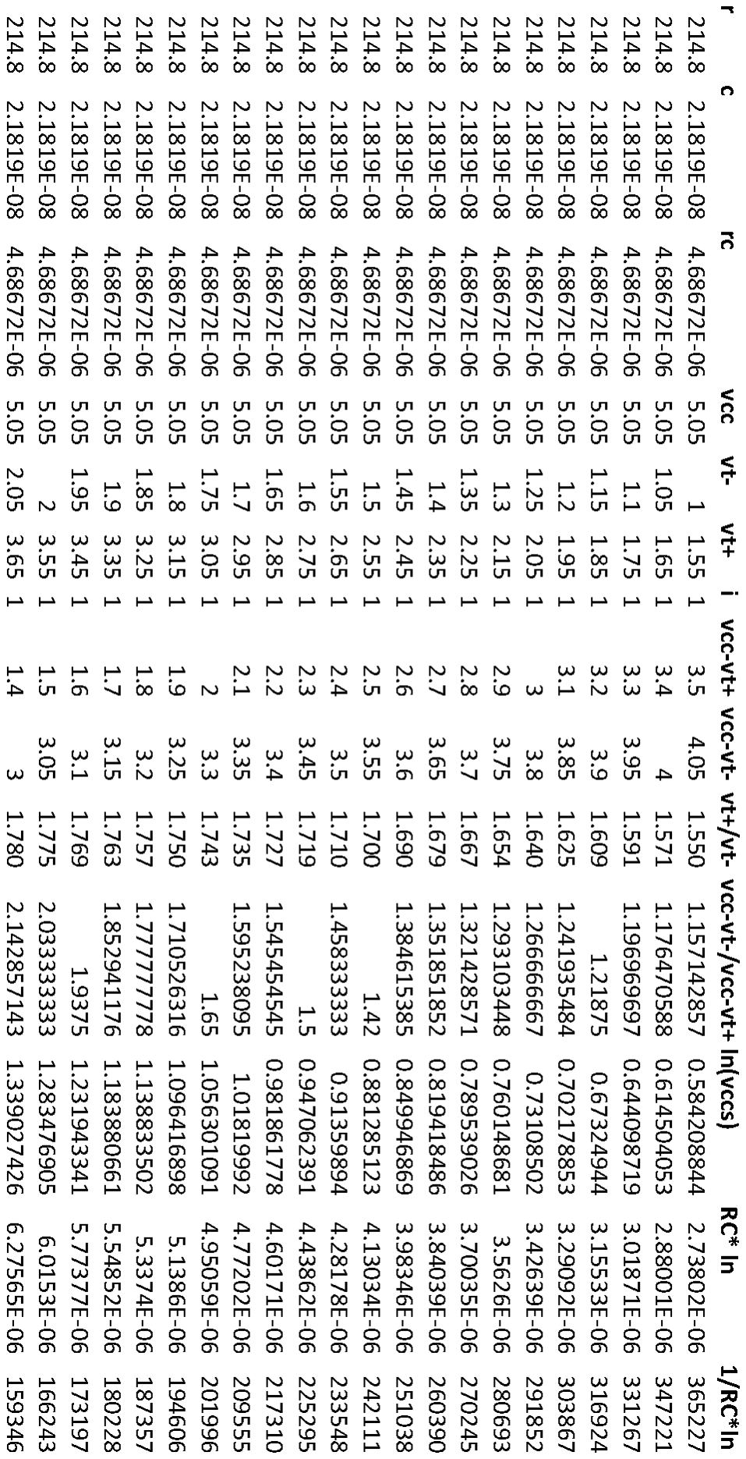
[picture p12: figure]
