adamsls/Analog-to-Digital-Converter/Images/1v pwm.bmp

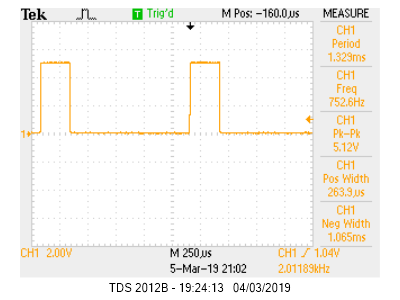
Images/1v pwm.bmp
