adamsls/Analog-to-Digital-Converter/Images/2v pwm.bmp

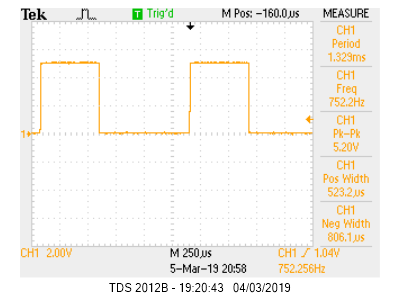
Images/2v pwm.bmp
