adamsls/Analog-to-Digital-Converter/Images/3v pwm.bmp

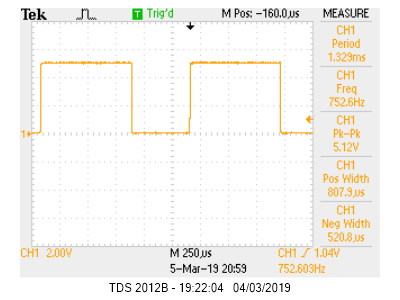
Images/3v pwm.bmp
