adamsls/Analog-to-Digital-Converter/Images/4v pwm.bmp

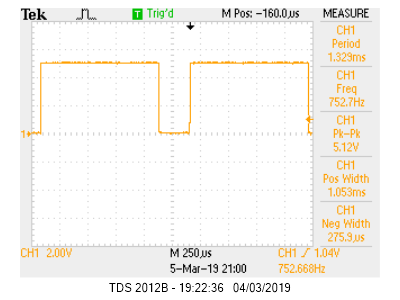
Images/4v pwm.bmp
