adamsls/Analog-to-Digital-Converter/Images/Cyc RMS AC - after R2R.bmp

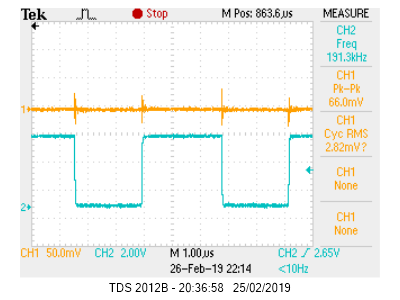
Images/Cyc RMS AC - after R2R.bmp
