adamsls/Analog-to-Digital-Converter/Images/Pin 1 counter.bmp

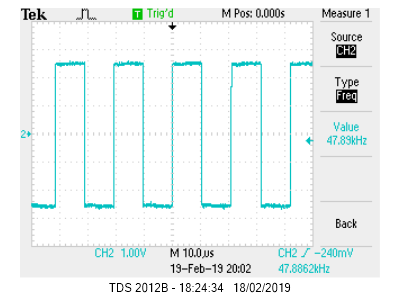
Images/Pin 1 counter.bmp
