adamsls/Analog-to-Digital-Converter/Images/Pin 7 counter.bmp

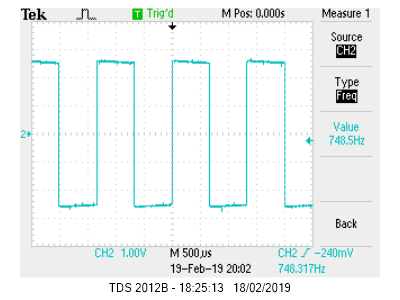
Images/Pin 7 counter.bmp
