adamsls/Analog-to-Digital-Converter/Images/Pin 9 counter.bmp

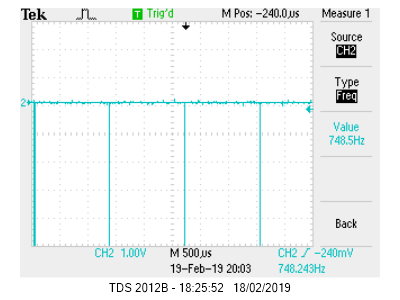
Images/Pin 9 counter.bmp
