adamsls/Analog-to-Digital-Converter/Images/Ramp 2.bmp

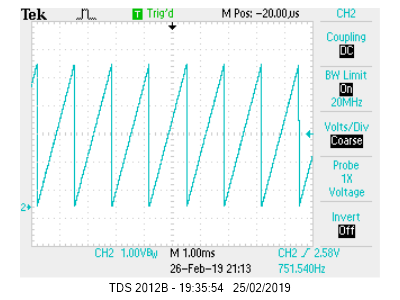
Images/Ramp 2.bmp
