adamsls/Analog-to-Digital-Converter/Images/Ramp 3.bmp

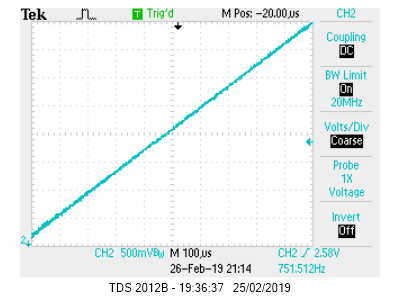
Images/Ramp 3.bmp
