adamsls/Analog-to-Digital-Converter/Images/Voltage step size.bmp

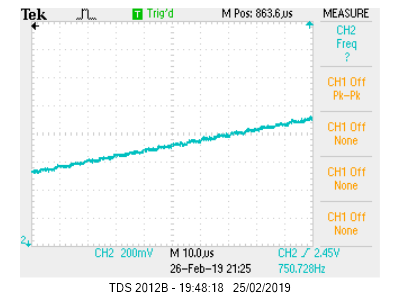
Images/Voltage step size.bmp
