adamsls/Analog-to-Digital-Converter/ADC_Arduino_Code/ADC_Arduino_Code.ino

/******************************************************************
Filename      :ADC Arduino Code 
Author        :Linda Adams

/******************************************************************
CONSTANT DEFINITNIONS
******************************************************************/
const int TSIG1 =  13;      //TSIG1 is located on pin 13
const int PWMX  =   8;      //PWMX is located o/n pin 2
const int PWMY  =   7;      //PWMX is located on pin 7
const int PWMZ  =   2;      //PWMX is located on pin 8

//variables for calibrated values
float calibrated_x_0;
float calibrated_x_180;
float calibrated_y_0;
float calibrated_y_180;
float calibrated_z_0;
float calibrated_z_180;

//variables for g forces in all three axes
float x_g_force = 0;
float y_g_force = 0;
float z_g_force = 0;


//flag for continuous serial values
boolean cont_flag = false;

/******************************************************************
MEASUREMENT TYPE DEFINITNIONS
******************************************************************/
#define   THI       1         //State for THI measurement
#define   TLO       0         //State for TLO measurement
#define   TPWM      2         //State for PWM period measurement
#define   VPWM      3         //State for Channel input voltage
#define   GF        5         //State for G-force
#define   SHOW      4         //State for displaying the results
#define   DONE      9         //End of measurements state

/******************************************************************
PROJECT BOARD VALUES
******************************************************************/
#define   TRAMP     1360      //Period of ramp in usec. Specific to each board
#define   TCLK      5.3      //Period of board clk in usec. Specific to each board
#define   VCC       5.06      //Board 5V level. Specific to each board

/******************************************************************
VARIABLE DEFINITNIONS
******************************************************************/
byte i_valid_char           =0;    
char kbd_data               ='0';
byte b_tsig1_state          =LOW;   //Holds the state of TSIG1, i.e. high or low. We startup as low

byte pwm_x_measurement      =THI;   //Each ch has a t-low, t-high measurement, start at t-high
byte ok_to_measure_pwmx     =0;     //Flag that is asserted when we want to measure PWMX

byte pwm_y_measurement      =THI;   //Each ch has a t-low, t-high measuremen                                                                                                         t, start at t-high
byte ok_to_measure_pwmy     =0;     //Flag that is asserted when we want to measure PWMX

byte pwm_z_measurement      =THI;   //Each ch has a t-low, t-high measurement, start at t-high
byte ok_to_measure_pwmz     =0;     //Flag that is asserted when we want to measure PWMX



/******************************************************************
PWM X measurement variables - initialise to 0
******************************************************************/
unsigned long   pwm_x_thi     =0;
unsigned long   pwm_x_tlo     =0;
unsigned long   pwm_x_tpwm    =0;
double          pwm_x_vin     =0;
double          pwm_x_g       =0;

unsigned long   pwm_y_thi     =0;
unsigned long   pwm_y_tlo     =0;
unsigned long   pwm_y_tpwm    =0;
double          pwm_y_vin     =0;
double          pwm_y_g       =0;

unsigned long   pwm_z_thi     =0;
unsigned long   pwm_z_tlo     =0;
unsigned long   pwm_z_tpwm    =0;
double          pwm_z_vin     =0;
double          pwm_z_g       =0;


void setup() {
  Serial.begin(9600);

  SendWelcomeMessage();
  
  pinMode(TSIG1, OUTPUT); 
//input will be taken from pins 2, 7 an 8 from accelerometer
  pinMode(PWMX, INPUT);
  pinMode(PWMY, INPUT);
  pinMode(PWMZ, INPUT);
}


void loop() {
  
//Check to see if there is new data from the serial port
  kbd_data = GetChar();  
  
//If the valid character flag is asserted then new data has been read into the
//serial port. We then run the menu to find out what command it is. The valid
//flag is used so we only execute each command once.
  if(i_valid_char ==1){
    Decode(kbd_data);    
  }
  i_valid_char =0;

//If the x key on the kbd is pressed then we call the function that measures
//the values for PWMX
  if(ok_to_measure_pwmx == 1){
    
    MeasurePWMX(pwm_x_measurement);
    delay(50);       

    
    if(pwm_x_measurement == DONE){
      if(cont_flag == true) {
         pwm_x_measurement = THI;
         ok_to_measure_pwmx = 1;        
    }
    else if (cont_flag == false){
       ok_to_measure_pwmx = 0;       
      }
    }
    
  }

    if(ok_to_measure_pwmy == 1){
    
    MeasurePWMY(pwm_y_measurement);    
    delay(50);                      
    
    if(pwm_y_measurement == DONE){
      if(cont_flag == true) {
         pwm_y_measurement = THI;
         ok_to_measure_pwmy = 1;       
    }
    else if (cont_flag == false){
       ok_to_measure_pwmy = 0;       
      }        
    }
    
  }

  if(ok_to_measure_pwmz == 1){
    
    MeasurePWMZ(pwm_z_measurement);
    delay(50);                 
    
    if(pwm_z_measurement == DONE){
      if(cont_flag == true) {
         pwm_z_measurement = THI;
         ok_to_measure_pwmz = 1;       
    }
    else if (cont_flag == false){
       ok_to_measure_pwmz = 0;       
      }     
    }
    
  }

}
