adamsls/Analog-to-Digital-Converter/(commit log)

2019-06-14 14th June
    [Bill of Materials - Linda Adams - x00150170 Project.xlsx, Output Frequency Calculation.xlsx]
2019-06-15 15th June
    [Bill of Materials - Linda Adams - x00150170 Project.xlsx]
2019-06-16 16th June 2
    [Bill of Materials - Linda Adams - x00150170 Project.xlsx]
2019-06-17 Update x00150170 ADC Project Report.docx
